shihua-hou/edge-monitor-gateway/docs/CAN通信协议.md

# CAN 通信协议定义（STM32 ↔ i.MX6ULL）

## 总线参数
- 波特率：500 Kbps（CAN1 时钟源 APB1=36MHz，Prescaler=4，BS1=9，BS2=8）
- 帧格式：标准帧（11 位 ID），数据长度 8 字节
- 终端：总线两端各 120Ω（i.MX6ULL 侧默认，STM32 侧按需）

## 帧 ID 规划
| 帧 ID | 方向 | 含义 |
|---|---|---|
| 0x100 | STM32 → i.MX6ULL | 状态上报（温度/光照/距离/系统状态） |
| 0x101 | STM32 → i.MX6ULL | IMU 姿态帧（俯仰/横滚/偏航） |
| 0x102 | STM32 → i.MX6ULL | 小车运动状态（左右轮转速/里程） |
| 0x103 | STM32 → i.MX6ULL | 左右轮**有符号位移**（航迹推算用，v2.6） |
| 0x110 | i.MX6ULL → STM32 | 控制命令（LED/蜂鸣器/电机） |
| 0x111 | i.MX6ULL → STM32 | 参数配置（上报周期/告警阈值） |
| 0x130 | i.MX6ULL → STM32 | **App 诊断请求**（升级前状态探测专用，仅支持 0x22 读版本 / 0x11 请求复位） |
| 0x120 | STM32 → i.MX6ULL | 诊断响应（Boot 的 UDS 应答与 App 的 0x130 诊断应答共用此 ID） |

> v2.1 变更：诊断相关请求单独占用 0x130，不再和 0x110 控制命令共享同一 ID。
> 旧版本设计里 App 也要在 0x110 上响应 0x10/0x22，靠首字节数值范围区分
> "这是控制命令"还是"这是诊断请求"，属于协议语义耦合在一起的脆弱设计，
> 且实际代码从未实现——现在改成独立 ID，Boot 区仍固定用 0x110/0x120
> （Boot 阶段 App 未运行，不存在冲突，见 docs/Bootloader_UDS设计.md）。

## 数据格式定义

### 0x100 状态上报（8 字节）
| 字节 | 内容 | 说明 |
|---|---|---|
| 0, 7 | 温度 | 有符号 16 位，单位 0.1℃（如 253=25.3℃），字节0=高字节，字节7=低字节，大端 |
| 1 | 光照 | 0~100% |
| 2 | 超声波距离高字节 | 单位 cm，大端 |
| 3 | 超声波距离低字节 | 单位 cm |
| 4 | 系统状态字 | bit0=LED, bit1=蜂鸣器, bit2=电机在转, bit3=急停 |
| 5~6 | 湿度 | 有符号 16 位，单位 0.1%（如 562=56.2%），大端 |

> v2.2 变更：温度原来只占字节0一个字节（有符号8位，范围-12.8~12.7℃），
> 正常室温读数（如25.3℃对应253）远超这个范围，`(int8_t)`一强转必然
> 变成负数——是协议设计阶段就埋下的缺陷，不是实现 bug。改成用原来完全
> 没用的字节7（保留位，恒为0）把温度也扩成两字节、大端，跟湿度的编码
> 方式一致。

> v2.3 变更：状态字的 **bit2 语义修正**。原来无论收到什么电机命令都只做
> `|= 0x04`，从不清零——按过一次"前进"之后这一位就永远是 1，界面上的电机
> 指示灯再也不会灭，哪怕车早就停了。**状态位如果只会置位、永不复位，
> 它表达的就不是"状态"而是"曾经发生过"**，对操作者是误导。
> 现在 `ACT_OFF`（停止）会把它清掉，bit2 真正表示"电机当前在转"。
>
> 这一位同时被上层用作**命令闭环确认**的依据：Web 大屏和 Qt 中控在下发
> 前进/后退/停止之后，会等这一位变成期望值才判定命令生效，并显示整条链路
> （浏览器→MQTT→网关→CAN→STM32→原路返回）的往返时延。转向和调速反映不到
> 状态位上，所以只标注为"已发送"，不谎称已确认。

> **v2.4 变更（底盘接入，2026-09-08）**：
>
> **① 0x102 的转速改成有符号。** 无符号的话倒车和前进长得一模一样，而
> "一侧轮子在反转"——抱死、接线反了、差速转向——这类真正需要看见的故障就此
> 隐形。-30 RPM 按无符号读出来是 65506：一个完全合法、不会报错、只是完全
> 错了的数字。网关侧 `gateway_can.c` / `gateway_mqtt.c` 已同步按 `int16_t` 解析。
>
> **② 状态字 bit2 改为由编码器实测推导**，不再由"最后一条命令"推导。
> v2.3 修好了"只置位不复位"，但用命令推导状态还是会在三种情况下说谎：
> 定时转向到期自己停了（没有命令来清位）、急停拉低 STBY 后轮子不转了
> （命令层看不到）、命令发了但电机堵死或线掉了（实际根本没转）。
> 有了编码器就不必再猜——上报时直接拿实测转速判定。
>
> **③ 新增 0x07 急停 / 0x08 解除急停。** 急停直接拉低 TB6612 的 STBY，
> 输出进高阻。**不走"PWM 置 0"这条路**：PWM=0 依赖定时器和固件都是好的，
> 而急停恰恰要在"固件可能不好"的时候生效。状态字 bit3 现在真正被用上了。

### 0x101 IMU 姿态帧（8 字节）
| 字节 | 内容 | 说明 |
|---|---|---|
| 0~1 | 俯仰角 | 有符号 16 位，0.01°（如 1500=15.00°） |
| 2~3 | 横滚角 | 有符号 16 位，0.01° |
| 4~5 | 偏航角 | 有符号 16 位，0.01°，已归一化到 (-180, 180] |
| 6 | **传感器健康位** | 见下表；置 1 表示该路数值是陈旧值 |
| 7 | 保留 | 0 |

**字节 6：传感器健康位**

| 位 | 掩码 | 传感器 | 判定条件 |
|----|---|---|---|
| 0 | 0x01 | 温湿度 DHT11 | 连续 3 次读取失败（约 3 秒） |
| 1 | 0x02 | 超声波 HC-SR04 | 连续 5 次返回 0（约 1 秒） |
| 2 | 0x04 | 光敏 ADC | 连续 5 次转换失败（约 1 秒） |
| 3 | 0x08 | 六轴 MPU6050 | 连续 25 次 I2C 读失败（约 0.5 秒） |

> **为什么需要这个字节**：所有传感器的失败值都长得像合法读数——DHT11 失败时
> 保留上次值、超声波超时返回 0（看着像"贴着障碍物"）、IMU 读失败以前直接
> 清零（0° 恰是最不可疑的姿态）。线松了、模块坏了，大屏上照样是一个稳定的
> 数字，没有任何人会发现。**对监控系统来说，"以为在看数据、其实在看一具
> 尸体"比直接报错严重得多。**
>
> 置位后，上层（Web 大屏 / Qt 中控）会把对应数值标成"已失联"，并且
> **不再用这个陈旧值做阈值告警**——传感器恰好在 41℃ 时坏掉的话，之后会永远
> 重复报"温度过高"，而真实温度早就降下来了。一条永不消失的假告警比没有
> 告警更糟，它会让人对整个告警系统失去信任。
>
> 这个字节放在 0x101 而不是 0x100，只是因为 0x100 的 8 字节已经排满
> （温度扩成两字节时用掉了最后一个保留位），跟"它描述的是哪些传感器"无关——
> 它描述的是全部四路。
>
> 对应实现：`firmware_stm32/app_task.h` 的 `SENS_FAULT_*`、
> `gateway_imx6ull/gateway_mqtt.c` 里转成 MQTT 的 `hf` 字段。

### 0x102 小车运动状态（8 字节）
| 字节 | 内容 | 说明 |
|---|---|---|
| 0~1 | 左轮转速 | RPM，**有符号** 16 位大端，正=前进 |
| 2~3 | 右轮转速 | RPM，**有符号** 16 位大端，正=前进 |
| 4~5 | 左轮累计里程 | cm，无符号 16 位 |
| 6~7 | 右轮累计里程 | cm，无符号 16 位 |

> **"里程"是路程，不是位移。** 这两个字节只增不减——倒车时它也在变大，
> 原地转向时左右轮都在变大。它对应的是汽车上的里程表，回答"这台车一共跑了多远"。
>
> **做航迹推算（算车在哪）绝不能用它**，要用 0x103。
> 用里程算位移的后果很具体：原地转一圈，左轮倒转、右轮正转，两边里程都在增加，
> 平均下来 `ds > 0`——于是每转一次弯，轨迹就凭空往前窜一段。
> 实测表现是"画出来的路线和实际走的对不上，正方形闭不回去"，
> 而且越是频繁转向偏得越多。这个坑实打实踩过，所以单开了 0x103。

### 0x103 左右轮有符号位移（8 字节，v2.6 新增）
| 字节 | 内容 | 说明 |
|---|---|---|
| 0~3 | 左轮累计位移 | mm，**有符号** 32 位大端，正=前进，倒车减小 |
| 4~7 | 右轮累计位移 | mm，**有符号** 32 位大端，正=前进，倒车减小 |

**为什么单开一帧而不是复用 0x102**：0x102 的 8 个字节已经排满了。

**为什么值得下位机来算**：上位机能看到的是 5Hz 的转速采样，两次采样之间的
加减速完全看不见；而下位机按**每个编码器计数**累加，一拍都不漏。
匀速直线时两者差不多，频繁起停和转弯时差得明显。

**发送顺序**：0x103 必须排在 0x102 **前面**。网关收到 0x103 只缓存不发，
等 0x102 到了才把两者合并成一条 MQTT 消息（`dl`/`dr` 字段）——
顺序反了的话每条消息里的位移都比转速旧一帧（200ms）。

**向后兼容**：老固件没有这一帧，网关就不输出 `dl`/`dr` 字段
（**不是填 0**——填 0 会让上位机以为车一直没动）。上位机检测到字段缺失时
退回用有符号转速积分，精度差一些但不会不可用。

### 0x110 控制命令（8 字节）
| 字节 | 内容 | 说明 |
|---|---|---|
| 0 | 目标设备 | 0x01=LED, 0x02=蜂鸣器, 0x03=电机(小车), 0x04=通用 |
| 1 | 动作 | 0x01=开/前进, 0x02=关/停止, 0x03=后退, 0x04=左转, 0x05=右转, 0x06=调速, **0x07=急停, 0x08=解除急停, 0x09=坦克式差速** |

> **0x09 坦克式差速（v2.5，路径跟踪用）**
> `p1` = 左轮、`p2` = 右轮，取值 **0~200 映射到 -100~+100 %**（减 100 得真值）。
>
> 为什么需要它：纯追踪要求每一拍都能**连续**调整左右轮速差，
> 而 0x01/0x04/0x05 这种离散命令只能"直走或原地转"，拼出来的轨迹会一摊一摊地摆。
>
> 为什么用偏移编码而不直接用有符号字节：`p1/p2` 在协议里一直是无符号语义
> （速度百分比）。改成有符号会让旧解析器对同一个字节得出完全不同的值，
> **而且不会报错**——倒车（负值）会被读成 150+ 的大正数，车以满速往前冲。
> 偏移编码把兼容风险限在新动作码内部。
>
> **自带 500ms 超时保护**：收到一次就启动计时，超时前没新指令就自动停车。
> 只给这个动作加超时、不给 0x01 加，是因为两者语义不同：
> 手动遥控是"一直跑到我叫停"，而坦克命令是**自主跟踪**在用——
> 上位机一旦卡死或崩溃，车会带着最后一条差速指令一直转圈跑下去。
> **自主模式下"指令流断了"必须等价于"停"。**
| 2 | 参数1 | 速度 / PWM 占空比(0~100) |
| 3 | 参数2 | 转向角度 / 持续时间 |
| 4~7 | 保留 | 0 |

### 0x111 参数配置（8 字节）
| 字节 | 内容 | 说明 |
|---|---|---|
| 0 | 配置项 | 0x01=上报周期, 0x02=温度告警阈值, 0x03=距离告警阈值 |
| 1~3 | 值 | 配置值（小端） |
| 4~7 | 保留 | 0 |

## 示例报文
- 上报温度 25.3℃、湿度 56.2%、光照 80%、超声波 45cm、状态正常：
  `ID=0x100  Data=00 50 00 2D 00 02 32 FD`
- 控制 LED 开：
  `ID=0x110  Data=01 01 00 00 00 00 00 00`
- 控制小车前进、PWM 60%：
  `ID=0x110  Data=03 01 3C 00 00 00 00 00`

## 注意事项
1. 两块板 CAN 接线：CANH↔CANH、CANL↔CANL、GND↔GND
2. 波特率必须一致（500K）
3. i.MX6ULL 侧使用 SocketCAN，`ip link set can0 up type can bitrate 500000`
4. 控制命令需回复执行结果（通过 0x100 状态字 bit 或单独回帧）形成闭环
