shihua-hou/edge-monitor-gateway/deploy/本轮部署清单.md

# 本轮部署清单

> **2026-09-06 11:50 更新：第 1~5 步已经由 Claude 通过 SSH 全部部署完成并验证。**
> 下面保留原步骤作为参考/回滚依据。**只剩第 6 步（STM32 固件）需要你在 Keil 里做。**
>
> 已完成并验证：
> - Web 大屏（`index.html` / `app.js`）—— md5 与本地一致
> - 历史服务（WAL 模式生效、查询接口返回真实数据、单实例锁在位）
> - 板子五个 C 程序（`gateway_mqtt` / `ota_service` / `video_v4l2` /
>   `uds_tool` / `screen_share`），全部零警告编译
> - 守护脚本（PATH、Qt 环境、单实例锁、拆卸前置检查、开机快速探测）
> - Qt 界面（远程抓屏确认文字与布局正常）
> - 旧二进制备份在板子 `/home/root/backup_0906_0311/`
>
> **构建方式的两个关键点**（原清单里写错了，已在事故中发现）：
> - `gateway_mqtt` / `ota_service` 必须带 `-Imosquitto-1.6.15/lib
>   -Lmosquitto-1.6.15/lib`，那个目录里只有 `.a` 没有 `.so`，
>   `-lmosquitto` 才会选静态库。直接用系统的动态 libmosquitto 编出来的
>   二进制只有 19KB（正确的是 362KB），ABI 未必对得上。
> - `screen_share` 要用 **Yocto SDK 工具链**编（`. /opt/fsl-imx-x11/...`），
>   `arm-linux-gnueabihf-gcc` 的 sysroot 里没有 `jconfig.h`，带不了 JPEG。

---

改动跨 4 个目标（STM32 / 板子 / VM / 浏览器）。按顺序走，每一步都能单独验证。
每处改动的原因见同目录的 `优化记录.md`。

> **一条硬约束**：OTA 的 topic 从全局改成了按设备
> （`monitor/ota/cmd` → `monitor/<dev>/ota/cmd`），
> **`ota_service` 和 `web` 必须一起更新**。只更新一边 OTA 会完全不通。

---

## 0. 改动前先自检（本机，几秒）

```bash
python scripts/brace_check.py .
```

输出"全部平衡"再往下走。这是本机唯一能做的结构校验（没有交叉编译器）。

---

## 1. Web 大屏（最快，先做这个）

改了 `index.html` 和 `app.js`。

```bash
scp -O "D:\UserFiles\Desktop\面试\远程监控系统_STM32_IMX6ULL\web\index.html" "D:\UserFiles\Desktop\面试\远程监控系统_STM32_IMX6ULL\web\app.js" user@192.168.100.6:~/edgemonitor/web/
```

浏览器打开 `http://192.168.100.6:8080/index.html?v=1`（带参数绕开缓存，
这次之后加的 no-cache 声明就生效了，以后普通 F5 即可）。

**验证**：

- 仪表盘：没接 GPS / 设备离线时，地图和视频面板显示带图标的空状态，不再是
  碎图图标和一片黑
- 设备控制页：多了「命令回执」面板。点 LED 开 → 设备在线时显示
  `已确认 xxx ms`；设备离线时 3 秒后变红「未生效」并弹告警
- 系统设置：APISecret 输入框是深色的，跟旁边一致（之前是白底）
- 告警中心：等级图标是自绘圆点，不是 emoji

---

## 2. 服务器侧历史服务（VM）

```bash
scp -O "D:\UserFiles\Desktop\面试\远程监控系统_STM32_IMX6ULL\server\history_logger.py" user@192.168.100.6:~/edgemonitor/server/
```

VM 上重启它（先确认旧的停了，新版有单实例锁，没停干净会直接拒绝启动）：

```bash
pkill -f history_logger.py; sleep 1; cd ~/edgemonitor/server && setsid python3 history_logger.py > /tmp/history.log 2>&1 < /dev/null & sleep 2; tail -5 /tmp/history.log
```

**验证**：日志里出现"history_logger 已启动"。再跑一次上面的命令应该被单实例锁
拦下并提示"已经有一个在运行"。

---

## 3. 板子上的 C 程序（VM 交叉编译 → 板子）

改了 `gateway_mqtt.c`、`ota_service.c`、`screen_share.c`、`video_v4l2.c`。

```bash
scp -O "D:\UserFiles\Desktop\面试\远程监控系统_STM32_IMX6ULL\gateway_imx6ull\gateway_mqtt.c" "D:\UserFiles\Desktop\面试\远程监控系统_STM32_IMX6ULL\gateway_imx6ull\ota_service.c" "D:\UserFiles\Desktop\面试\远程监控系统_STM32_IMX6ULL\gateway_imx6ull\screen_share.c" "D:\UserFiles\Desktop\面试\远程监控系统_STM32_IMX6ULL\gateway_imx6ull\video_v4l2.c" user@192.168.100.6:~/edgemonitor/
```

VM 上编译（这几个用 `arm-linux-gnueabihf-gcc`，**不需要** source Qt SDK）：

```bash
cd ~/edgemonitor && arm-linux-gnueabihf-gcc -Wall gateway_mqtt.c -o gateway_mqtt -lmosquitto -lpthread && arm-linux-gnueabihf-gcc -Wall ota_service.c -o ota_service -lmosquitto -lpthread && arm-linux-gnueabihf-gcc -Wall video_v4l2.c -o video_v4l2 -lpthread && arm-linux-gnueabihf-gcc -Wall -DUSE_JPEG screen_share.c -o screen_share -ljpeg -lpthread && echo "四个都编过了"
```

> 有 warning 要看一眼再决定忽略。`-Wall` 报的 unused/未初始化，往往就是真 bug。

传板子（正在运行的二进制不能直接覆盖，会报 `Text file busy`）：

```bash
cd ~/edgemonitor && for f in gateway_mqtt ota_service video_v4l2 screen_share; do scp -o HostKeyAlgorithms=+ssh-rsa $f root@192.168.100.3:/home/root/$f.new; done && echo "传完了"
```

板子上替换 + 重启（守护脚本 10 秒内会拉起来）：

```bash
cd /home/root && for f in gateway_mqtt ota_service video_v4l2 screen_share; do mv -f $f.new $f && chmod +x $f; done && killall gateway_mqtt ota_service video_v4l2 screen_share; sleep 12; ps | grep -v grep | grep -cE "gateway_mqtt|ota_service|video_v4l2|screen_share"
```

最后一行输出 **4** 表示四个都起来了。

**验证**：

```bash
head -20 /tmp/em_gateway_mqtt.log; echo "--- OTA topic ---"; grep -a "命令 topic" /tmp/em_ota_service.log
```

OTA 那行应该是 `monitor/robot01/ota/cmd`（带设备号）。

---

## 4. 守护脚本（板子）

```bash
scp -O -o HostKeyAlgorithms=+ssh-rsa "D:\UserFiles\Desktop\面试\远程监控系统_STM32_IMX6ULL\deploy\sysvinit\edgemonitor-daemon.sh" root@192.168.100.3:/home/root/edgemonitor-daemon.sh.new
```

板子上（**先杀干净再换**，否则会有两个守护进程）：

```bash
ps | grep -v grep | grep edgemonitor-daemon | awk '{print $1}' | xargs -r kill; sleep 1; mv -f /home/root/edgemonitor-daemon.sh.new /home/root/edgemonitor-daemon.sh && chmod +x /home/root/edgemonitor-daemon.sh && setsid /home/root/edgemonitor-daemon.sh >/tmp/em_daemon.log 2>&1 </dev/null & sleep 70; cat /tmp/em_daemon.log
```

**验证**：约 1 分钟后日志出现「网络自愈已启用」和「校时完成」两行。

---

## 5. Qt 中控（VM 交叉编译 → 板子）

改了 `dashboardpage.cpp/.h`、`attitudewidget.cpp/.h`、`mainwindow.cpp/.h`、
`mqttclient.cpp`、`controlpage.cpp/.h`、`weatherclient.cpp`。

```bash
scp -O "D:\UserFiles\Desktop\面试\远程监控系统_STM32_IMX6ULL\imx6ull_ui\dashboardpage.cpp" "D:\UserFiles\Desktop\面试\远程监控系统_STM32_IMX6ULL\imx6ull_ui\dashboardpage.h" "D:\UserFiles\Desktop\面试\远程监控系统_STM32_IMX6ULL\imx6ull_ui\attitudewidget.cpp" "D:\UserFiles\Desktop\面试\远程监控系统_STM32_IMX6ULL\imx6ull_ui\attitudewidget.h" "D:\UserFiles\Desktop\面试\远程监控系统_STM32_IMX6ULL\imx6ull_ui\mainwindow.cpp" "D:\UserFiles\Desktop\面试\远程监控系统_STM32_IMX6ULL\imx6ull_ui\mainwindow.h" "D:\UserFiles\Desktop\面试\远程监控系统_STM32_IMX6ULL\imx6ull_ui\mqttclient.cpp" "D:\UserFiles\Desktop\面试\远程监控系统_STM32_IMX6ULL\imx6ull_ui\controlpage.cpp" "D:\UserFiles\Desktop\面试\远程监控系统_STM32_IMX6ULL\imx6ull_ui\controlpage.h" "D:\UserFiles\Desktop\面试\远程监控系统_STM32_IMX6ULL\imx6ull_ui\weatherclient.cpp" user@192.168.100.6:~/edgemonitor/imx6ull_ui/
```

VM 上（**新终端必须先 source**，否则 make 会静默链接旧 .o）：

```bash
source /opt/fsl-imx-x11/4.1.15-2.1.0/environment-setup-cortexa7hf-neon-poky-linux-gnueabi && cd ~/edgemonitor/imx6ull_ui && make -j4
```

```bash
cd ~/edgemonitor/imx6ull_ui && scp -o HostKeyAlgorithms=+ssh-rsa edgemonitor_ui root@192.168.100.3:/home/root/edgemonitor_ui.new
```

```bash
mv -f /home/root/edgemonitor_ui.new /home/root/edgemonitor_ui && chmod +x /home/root/edgemonitor_ui && > /tmp/em_edgemonitor_ui.log && killall edgemonitor_ui
```

**验证**：

1. `/tmp/em_edgemonitor_ui.log` 里**不再有** `received PUBLISH` 刷屏
   （只剩警告和错误）。这是判断新版是否生效最直接的标志。
2. 6U 屏幕 →「控制」页，点一下 LED：按钮下方出现「LED 开 已下发，等待回执…」，
   随后变成绿色的「已确认（往返 xxx ms）」。
3. 拔掉 CAN 线再点一次：3 秒后变成红色「未生效」。

---

## 6. STM32 固件（Keil，需要你手动操作）

改了 `app_task.c/.h`、`sensor/mpu6050.c/.h`、`sensor/adc_light.c/.h`、
`sensor/hcsr04.c/.h`、`sensor/dht11.c`。
**两份副本已经同步过**（`scripts/sync_firmware.py --push`，18/18 一致）。

1. Keil 打开 `EdgeMonitor_App`，直接编译（没有新增文件，不用改工程配置）
2. 编出 `_a.bin` 和 `_b.bin` 两份
3. 通过网页 OTA 上传升级，或用 J-Link 直刷

**验证**（升级后看串口）：

- 正常运行时不再刷 `DHT11 widths` 之类的调试信息
- 拔掉 DHT11 数据线 3 秒后，Web 仪表盘的温湿度环变虚线灰圈、数值下出现
  「已失联」，告警中心出现「温湿度传感器失联」
- 插回去 1 秒内标记消失，出现「已恢复」
- 偏航角连续转动不再出现 ±327° 的突跳

---

## 7. STM32 Bootloader（可选，需要 J-Link）

改了 `firmware_stm32/bootloader/boot_main.c` 和 `EdgeMonitor_Boot/User/main.c`
（两份已同步且代码部分完全一致）。

**只改了 CAN 初始化失败时的处理**：原来是 `while(1)` 死等（= 整机变砖），
现在是打印原因后照常去启动 App。

> **这一步可以不做。** 它修的是"CAN 外设初始化失败"这个从没实际发生过的
> 场景，属于防御性加固；而刷 Bootloader **必须用 J-Link/SWD**——OTA 只更新
> App 区，刷不了 Boot。刷 Boot 的过程本身比它要修的问题风险更高。
>
> 建议：等下次因为别的原因要动 Boot 时顺带一起刷，不为这一条单独操作。

真要刷的话：Keil 打开 `EdgeMonitor_Boot` 编译，J-Link 烧到 `0x08000000`。
烧完**务必先确认板子能正常启动 App**（串口打印 `Boot active slot A` 之后
App 的采集日志正常出现），再做别的事。

---

## 一句话回归检查

全部部署完之后，确认这三件事没被搞坏：

1. 大屏上温度/湿度/光照/距离四个环正常跳动（数据通路没断）
2. 点 LED 开关，板子上的灯真的亮灭，命令回执显示「已确认」（控制通路没断）
3. 6U 屏幕上四个数值正常刷新（Qt 侧没崩）
