shihua-hou/edge-monitor-gateway/(commit log)

2026-09-08 feat: EdgeMonitor 巡检机器人远程监控与 OTA 系统
    STM32F103 + i.MX6ULL 的完整闭环：多传感器采集、CAN 总线、边缘网关、
    MQTT 上云、Web 数据大屏、Qt 现场中控、V4L2 视频回传、UDS/A-B 双分区 OTA、
    TB6612 电机 PI 闭环。
    可靠性设计围绕一个前提：没人在现场。传感器健康位、网络/CAN 自愈、
    IWDG 签到式喂狗、升级失败自动回滚、命令闭环确认。
2026-09-20 feat: 车载地图/中文输入/板载 broker + ACL/NTRIP 差分/指令流路线录制
    - 地图页：自绘高德瓦片渲染 + POI 搜索 + 路径规划，WGS84->GCJ02 转换
    - 中文输入：自绘键盘加中英切换与拼音候选，离线词库 610KB（jieba 词频 + pypinyin 读音）
    - broker 搬到板子：车不再依赖上位机，VM 改为桥接旁观；三账号 ACL 按读写方向分权
    - CAN v2.6：新增 0x103 有符号位移帧，修正里程被当位移用导致的轨迹漂移
    - NTRIP 差分客户端做进 gps_mqtt，绕开模块 4G；串口自动识别 NMEA 口
    - 路线录制改为指令流回放，去掉误差链过长的位置推算
    - 手机遥控加访问令牌；语音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
    [app_task.c, app_task.h, appconfig.cpp, attitudewidget.cpp, can.h, chatpage.cpp, controlpage.cpp, controlpage.h]
2026-09-29 fix: 桥接改用 mDNS 主机名，板子换 IP 不再断链；修 .gitattributes 注释转义被转成真换行
2026-09-29 fix: 大屏地图默认南航将军路校区并换高德瓦片；修水平仪地平线错位与航向显示；视频断线自动重连；桥接改用 mDNS 主机名
2026-09-29 fix: 视频改为服务器同源中转，解决浏览器拦截跨设备请求与远程访问不到板子；视频服务自动找摄像头并在采集失败后重启；大屏地图/水平仪/航向修复
2026-09-29 docs: README 换用实机截图（大屏/登录/控制/告警/历史/OTA/设置），补视频中转与部署说明；feat: 大屏美化
